ne0phyte/chu_cheapo/PCB/main/chu_main.kicad_pcb

## KiCad design PCB/main/chu_main.kicad_pcb (2024-06-12)

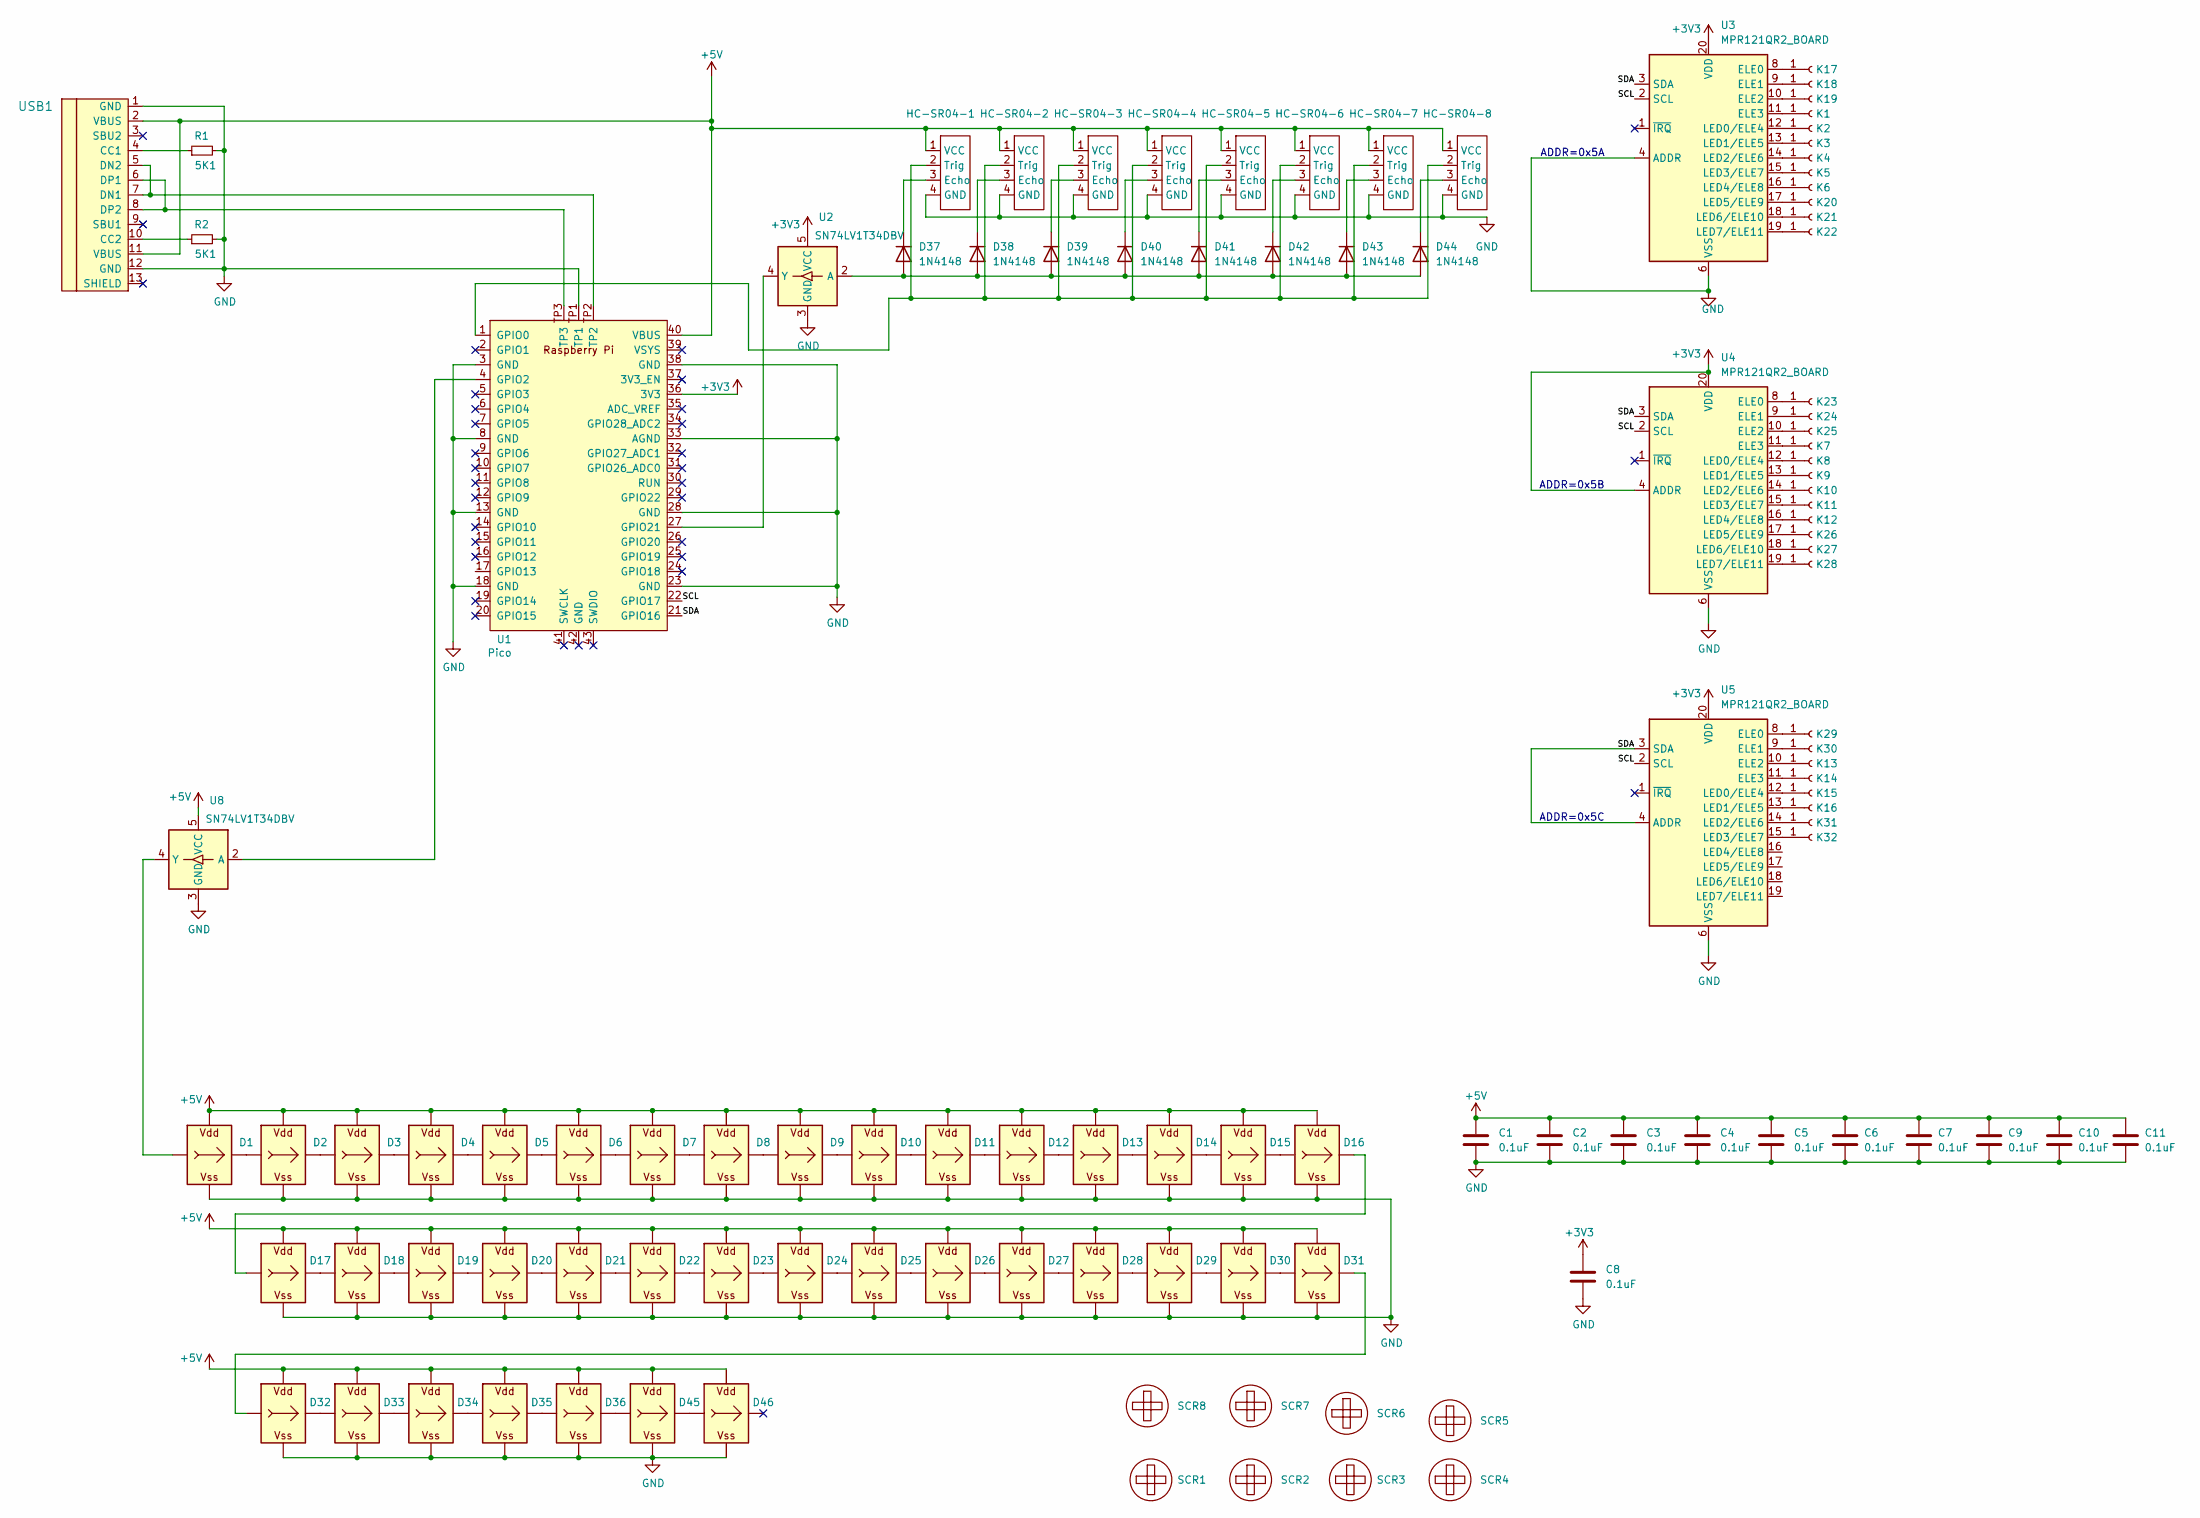
[picture p1: schematic chu_main.kicad_sch]

Parts:
C1, C2, C3, C4, C5, C6, C7, C8, C9, C10, C11: 0.1uF; C_0603_1608Metric_Pad1.08x0.95mm_HandSolder
D1, D2, D3, D4, D5, D6, D7, D8, D9, D10, D11, D12, D13, D14, D15, D16, D17, D18, D19, D20, D21, D22, D23, D24, D25, D26, D27, D28, D29, D30, D31, D32, D33, D34, D35, D36, D45, D46: WS2812B_Unified; WS2812D-F5
D37, D38, D39, D40, D41, D42, D43, D44: 1N4148; D_DO-35_SOD27_P7.62mm_Horizontal
HC-SR04-1, HC-SR04-2, HC-SR04-3, HC-SR04-4, HC-SR04-5, HC-SR04-6, HC-SR04-7, HC-SR04-8: HC-SR04
K1, K2, K3, K4, K5, K6, K7, K8, K9, K10, K11, K12, K13, K14, K15, K16, K17, K18, K19, K20, K21, K22, K23, K24, K25, K26, K27, K28, K29, K30, K31, K32: Conn_01x01_Female; Chu_TouchKey
R1, R2: 5K1; R_0603_1608Metric; LCSC C23186
SCR1, SCR2, SCR3, SCR4, SCR5, SCR6, SCR7, SCR8: ScrewHole; MountingHole_3.2mm_M3
U1: Pico; RPi_Pico_SMD_Pins_Strip
U2, U8: SN74LV1T34DBV; SOT-23-5_Jumper
U3, U4, U5: MPR121QR2_BOARD; MPR121_BOARD
USB1: U262-161N-4BVC11; HRO-TYPE-C-31-M-12-Assembly; LCSC C319148

Connections:
+3V3: C8.1, U1.36 (3V3), U2.5 (VCC), U3.20 (VDD), U4.4 (ADDR), U4.20 (VDD), U5.20 (VDD)
+5V: C1.1, C2.1, C3.1, C4.1, C5.1, C6.1, C7.1, C9.1, C10.1, C11.1, D1.V (VDD), D2.V (VDD), D3.V (VDD), D4.V (VDD), D5.V (VDD), D6.V (VDD), D7.V (VDD), D8.V (VDD), D9.V (VDD), D10.V (VDD), D11.V (VDD), D12.V (VDD), D13.V (VDD), D14.V (VDD), D15.V (VDD), D16.V (VDD), D17.V (VDD), D18.V (VDD), D19.V (VDD), D20.V (VDD), D21.V (VDD), D22.V (VDD), D23.V (VDD), D24.V (VDD), D25.V (VDD), D26.V (VDD), D27.V (VDD), D28.V (VDD), D29.V (VDD), D30.V (VDD), D31.V (VDD), D32.V (VDD), D33.V (VDD), D34.V (VDD), D35.V (VDD), D36.V (VDD), D45.V (VDD), D46.V (VDD), HC-SR04-1.1 (VCC), HC-SR04-2.1 (VCC), HC-SR04-3.1 (VCC), HC-SR04-4.1 (VCC), HC-SR04-5.1 (VCC), HC-SR04-6.1 (VCC), HC-SR04-7.1 (VCC), HC-SR04-8.1 (VCC), U1.40 (VBUS), U8.5 (VCC), USB1.2 (VBUS), USB1.11 (VBUS)
/SCL: U1.22 (GPIO17), U3.2 (SCL), U4.2 (SCL), U5.2 (SCL)
/SDA: U1.21 (GPIO16), U3.3 (SDA), U4.3 (SDA), U5.3 (SDA), U5.4 (ADDR)
GND: C1.2, C2.2, C3.2, C4.2, C5.2, C6.2, C7.2, C8.2, C9.2, C10.2, C11.2, D1.G (VSS), D2.G (VSS), D3.G (VSS), D4.G (VSS), D5.G (VSS), D6.G (VSS), D7.G (VSS), D8.G (VSS), D9.G (VSS), D10.G (VSS), D11.G (VSS), D12.G (VSS), D13.G (VSS), D14.G (VSS), D15.G (VSS), D16.G (VSS), D17.G (VSS), D18.G (VSS), D19.G (VSS), D20.G (VSS), D21.G (VSS), D22.G (VSS), D23.G (VSS), D24.G (VSS), D25.G (VSS), D26.G (VSS), D27.G (VSS), D28.G (VSS), D29.G (VSS), D30.G (VSS), D31.G (VSS), D32.G (VSS), D33.G (VSS), D34.G (VSS), D35.G (VSS), D36.G (VSS), D45.G (VSS), D46.G (VSS), HC-SR04-1.4 (GND), HC-SR04-2.4 (GND), HC-SR04-3.4 (GND), HC-SR04-4.4 (GND), HC-SR04-5.4 (GND), HC-SR04-6.4 (GND), HC-SR04-7.4 (GND), HC-SR04-8.4 (GND), R1.2, R2.2, U1.3 (GND), U1.8 (GND), U1.13 (GND), U1.18 (GND), U1.23 (GND), U1.28 (GND), U1.33 (AGND), U1.38 (GND), U1.TP1, U2.3 (GND), U3.4 (ADDR), U3.6 (VSS), U4.6 (VSS), U5.6 (VSS), U8.3 (GND), USB1.1 (GND), USB1.12 (GND)
unnamed: D1.I (In), U8.4 (Y)
unnamed: D1.O (Out), D2.I (In)
unnamed: D2.O (Out), D3.I (In)
unnamed: D3.O (Out), D4.I (In)
unnamed: D4.O (Out), D5.I (In)
unnamed: D5.O (Out), D6.I (In)
unnamed: D6.O (Out), D7.I (In)
unnamed: D7.O (Out), D8.I (In)
unnamed: D8.O (Out), D9.I (In)
unnamed: D9.O (Out), D10.I (In)
unnamed: D10.O (Out), D11.I (In)
unnamed: D11.O (Out), D12.I (In)
unnamed: D12.O (Out), D13.I (In)
unnamed: D13.O (Out), D14.I (In)
unnamed: D14.O (Out), D15.I (In)
unnamed: D15.O (Out), D16.I (In)
unnamed: D16.O (Out), D17.I (In)
unnamed: D17.O (Out), D18.I (In)
unnamed: D18.O (Out), D19.I (In)
unnamed: D19.O (Out), D20.I (In)
unnamed: D20.O (Out), D21.I (In)
unnamed: D21.O (Out), D22.I (In)
unnamed: D22.O (Out), D23.I (In)
unnamed: D23.O (Out), D24.I (In)
unnamed: D24.O (Out), D25.I (In)
unnamed: D25.O (Out), D26.I (In)
unnamed: D26.O (Out), D27.I (In)
unnamed: D27.O (Out), D28.I (In)
unnamed: D28.O (Out), D29.I (In)
unnamed: D29.O (Out), D30.I (In)
unnamed: D30.O (Out), D31.I (In)
unnamed: D31.O (Out), D32.I (In)
unnamed: D32.O (Out), D33.I (In)
unnamed: D33.O (Out), D34.I (In)
unnamed: D34.O (Out), D35.I (In)
unnamed: D35.O (Out), D36.I (In)
unnamed: D36.O (Out), D45.I (In)
unnamed: D37.2 (A), D38.2 (A), D39.2 (A), D40.2 (A), D41.2 (A), D42.2 (A), D43.2 (A), D44.2 (A), U2.2 (A)
unnamed: D37.1 (K), HC-SR04-1.3 (Echo)
unnamed: D38.1 (K), HC-SR04-2.3 (Echo)
unnamed: D39.1 (K), HC-SR04-3.3 (Echo)
unnamed: D40.1 (K), HC-SR04-4.3 (Echo)
unnamed: D41.1 (K), HC-SR04-5.3 (Echo)
unnamed: D42.1 (K), HC-SR04-6.3 (Echo)
unnamed: D43.1 (K), HC-SR04-7.3 (Echo)
unnamed: D44.1 (K), HC-SR04-8.3 (Echo)
unnamed: D45.O (Out), D46.I (In)
unnamed: HC-SR04-1.2 (Trig), HC-SR04-2.2 (Trig), HC-SR04-3.2 (Trig), HC-SR04-4.2 (Trig), HC-SR04-5.2 (Trig), HC-SR04-6.2 (Trig), HC-SR04-7.2 (Trig), HC-SR04-8.2 (Trig), U1.1 (GPIO0)
unnamed: K1.1, U3.11 (ELE3)
unnamed: K2.1, U3.12 (LED0/ELE4)
unnamed: K3.1, U3.13 (LED1/ELE5)
unnamed: K4.1, U3.14 (LED2/ELE6)
unnamed: K5.1, U3.15 (LED3/ELE7)
unnamed: K6.1, U3.16 (LED4/ELE8)
unnamed: K7.1, U4.11 (ELE3)
unnamed: K8.1, U4.12 (LED0/ELE4)
unnamed: K9.1, U4.13 (LED1/ELE5)
unnamed: K10.1, U4.14 (LED2/ELE6)
unnamed: K11.1, U4.15 (LED3/ELE7)
unnamed: K12.1, U4.16 (LED4/ELE8)
unnamed: K13.1, U5.10 (ELE2)
unnamed: K14.1, U5.11 (ELE3)
unnamed: K15.1, U5.12 (LED0/ELE4)
unnamed: K16.1, U5.13 (LED1/ELE5)
unnamed: K17.1, U3.8 (ELE0)
unnamed: K18.1, U3.9 (ELE1)
unnamed: K19.1, U3.10 (ELE2)
unnamed: K20.1, U3.17 (LED5/ELE9)
unnamed: K21.1, U3.18 (LED6/ELE10)
unnamed: K22.1, U3.19 (LED7/ELE11)
unnamed: K23.1, U4.8 (ELE0)
unnamed: K24.1, U4.9 (ELE1)
unnamed: K25.1, U4.10 (ELE2)
unnamed: K26.1, U4.17 (LED5/ELE9)
unnamed: K27.1, U4.18 (LED6/ELE10)
unnamed: K28.1, U4.19 (LED7/ELE11)
unnamed: K29.1, U5.8 (ELE0)
unnamed: K30.1, U5.9 (ELE1)
unnamed: K31.1, U5.14 (LED2/ELE6)
unnamed: K32.1, U5.15 (LED3/ELE7)
unnamed: U1.4 (GPIO2), U8.2 (A)
unnamed: U1.27 (GPIO21), U2.4 (Y)
unnamed: R1.1, USB1.4 (CC1)
unnamed: R2.1, USB1.10 (CC2)
unnamed: U1.TP2, USB1.5 (DN2), USB1.7 (DN1)
unnamed: U1.TP3, USB1.6 (DP1), USB1.8 (DP2)

Notes on the sheet:
ADDR=0x5C
ADDR=0x5A
ADDR=0x5B

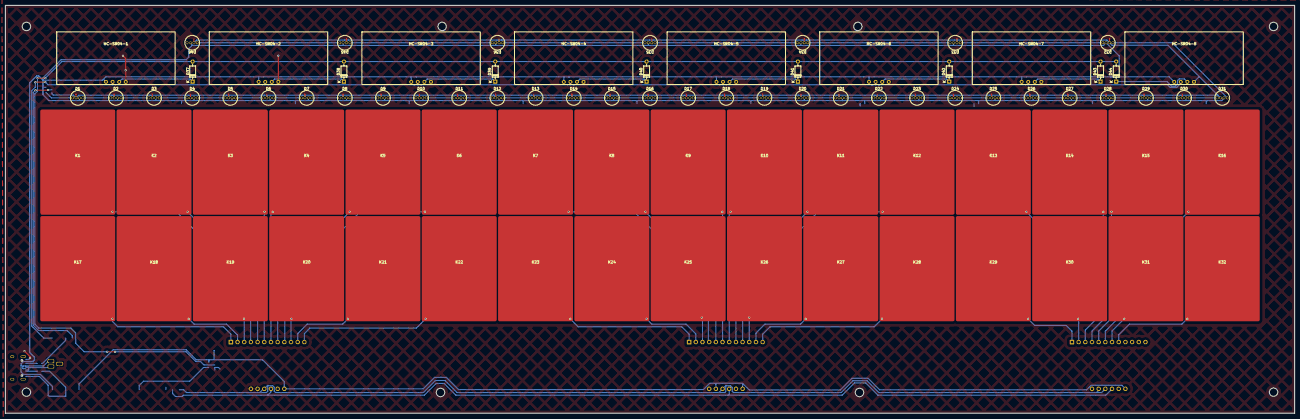
[picture p2: board chu_main.kicad_pcb from above]

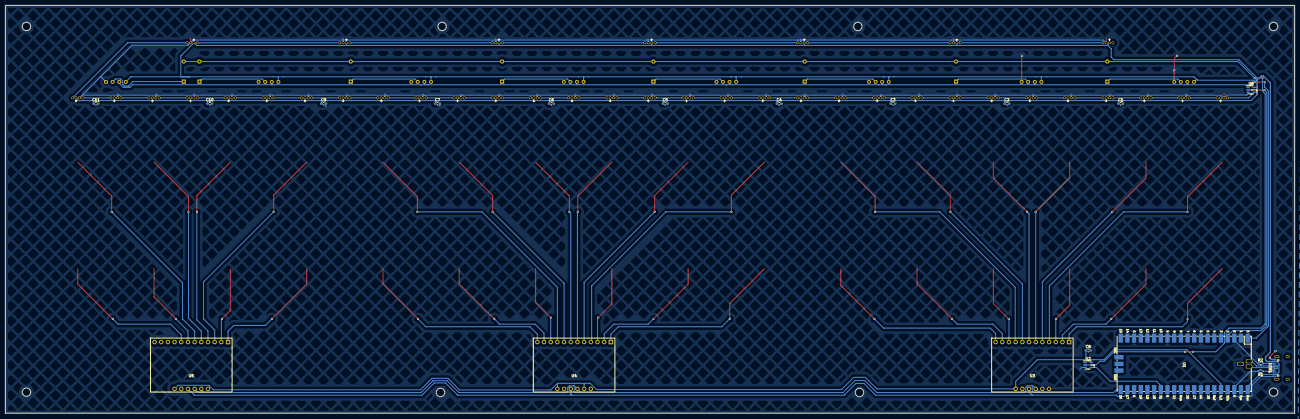
[picture p3: board chu_main.kicad_pcb from below]

Board: 2 copper layers, 490.0 x 155.0 mm, 114 parts (20 on the bottom side), 91 nets.
