ne0phyte/chu_cheapo/(commit log)

2024-06-12 wip full size pcb with hc-sr04 ultrasonic sensors
    [chu_main.kicad_pcb, chu_main.kicad_sch]
2024-06-12 add full size pcb
    [chu_main-B_Cu.gbl, chu_main-B_Mask.gbs, chu_main-B_Paste.gbp, chu_main-B_Silkscreen.gbo, chu_main-Edge_Cuts.gm1, chu_main-F_Cu.gtl, chu_main-F_Mask.gts, chu_main-F_Paste.gtp]
2024-06-21 Remove aime, update pins, fix slider code
    [air.c, commands.c, main.c, slider.c]
